easy-smart/stm32f4_uno_ethernet/production/jlcpcb_STM32F4_Uno_Ethernet_1.0.0_2023-10-03_12-42-28/jlcO2U302HH33UXtop-4480x3200.png

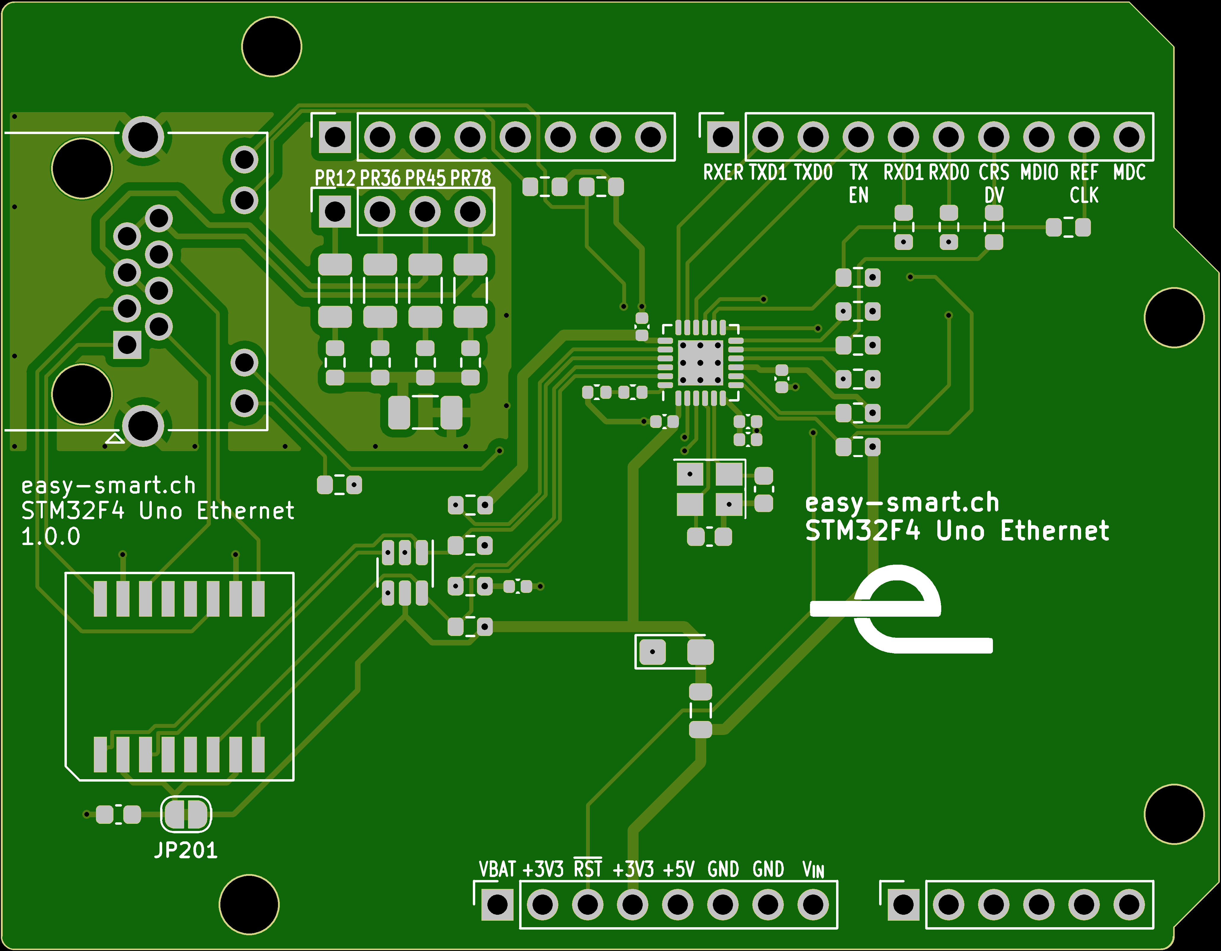
production/jlcpcb_STM32F4_Uno_Ethernet_1.0.0_2023-10-03_12-42-28/jlcO2U302HH33UXtop-4480x3200.png
