easy-smart/stm32f4_uno_ethernet/production/jlcpcb_STM32F4_Uno_Ethernet_1.0.0_2023-10-03_12-42-28/Produce_DanZhi.SMT_Snapshot.Top.4825844A_Y18.SMT02310031417726.png

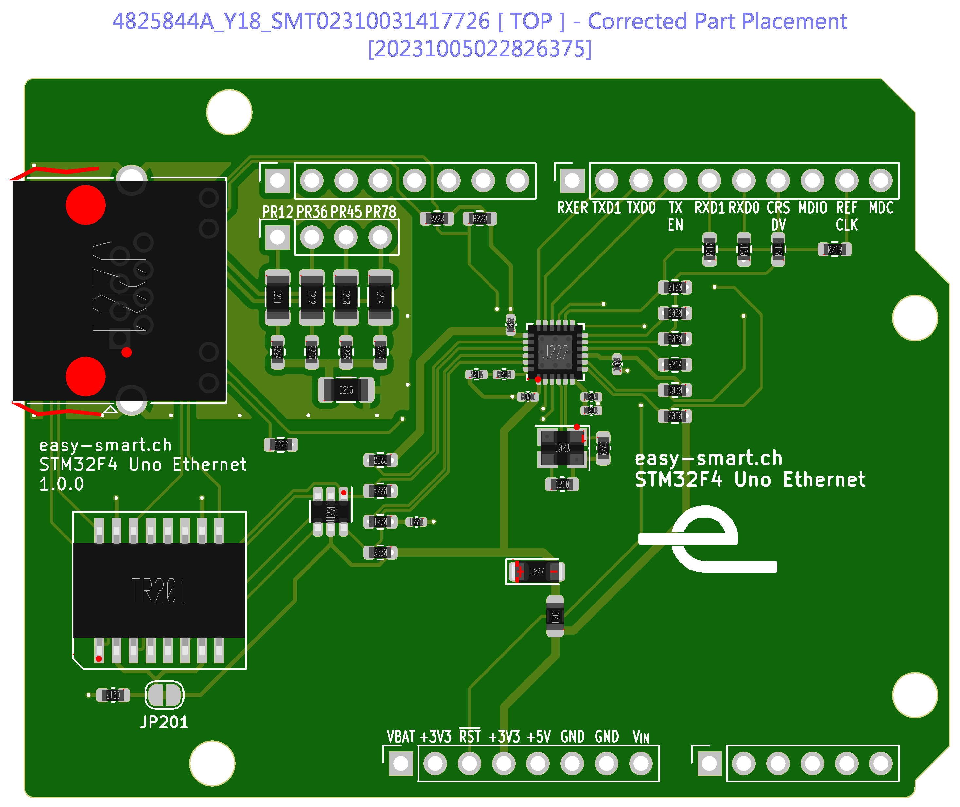
production/jlcpcb_STM32F4_Uno_Ethernet_1.0.0_2023-10-03_12-42-28/Produce_DanZhi.SMT_Snapshot.Top.4825844A_Y18.SMT02310031417726.png
