easy-smart/stm32f4_uno_ethernet/doc/MB1225-F769I-B02_BOM.xlsx

 |  |  | Bill of materials
 |  |  | Board reference: | MB1225
 |  |  | Variant: | None
 |  |  | PCB revision: | B
 |  |  | Assembly revision: | 02
 |  |  | Date: | 30/05/2019
Designator | Description | Value | Footprint | Manuf_1 | Manuf_Part_1 | Fitted | Solder | Quantity
B1 | Non-Open Push-Button 0.1A 24V |  | PB10 | wealthmetal | TD0341X-G01-BLU |  |  | 1
B2 | Non-Open Push-Button 0.1A 24V |  | PB10 | wealthmetal | TD0341X-G01-BLA |  |  | 1
C1, C2, C60 | Capacitor,100nF,16V,X7R,10%,0603,YAGEO | 100nF | 0603C | YAGEO | CC0603KRX7R9BB104 |  |  | 3
C3 | Capacitor,1nF,2KV,X7R,10%,1206,YAGEO | 1nF | 1206C | YAGEO | CC1206KKX7RDBB102 |  |  | 1
C4, C8, C39, C121, C122 | Capacitor,1nF,100V,X7R,10%,0603,YAGEO | 1nF | 0603C | YAGEO | CC0603KRX7R0BB102 |  |  | 5
C5, C10 | Capacitor,10nF,100V,X7R,10%,0603,YAGEO | 10nF | 0603C | YAGEO | CC0603KRX7R0BB103 |  |  | 2
C6, C7, C11, C12 | Capacitor,100nF,50V,X7R,10%,0603,YAGEO | 100nF | 0603C | YAGEO | CC0603KRX7R9BB104 |  |  | 4
C9 | Capacitor,470pF,100V,X7R,10%,0603,AVX | 470pF | 0603C | AVX | 06031C471KAT2A |  |  | 1
C13, C14, C15, C18 | Capacitor,47uF,10V,X5R,20%,0805,MURATA | 47uF | 0805C | MURATA | GRM21BR61A476ME15K |  |  | 4
C16 | Capacitor,100nF,16V,X7R,10%,0603,YAGEO | 100nF | 0603C | YAGEO | CC0603KRX7R9BB104 |  |  | 1
C17 | Capacitor,100pF,50V,X7R,10%,0603,AVX | 100pF | 0603C | AVX | 06035C101JAT4A |  |  | 1
C19 | Capacitor,22nF,50V,X7R,10%,0603,YAGEO | 22nF | 0603C | YAGEO | CC0603KRX7R9BB223 |  |  | 1
C20, C70, C75 | Capacitor,4.7uF,100V, X7S,20%,1206,AVX | 4.7uF | 1206C | AVX | 12061Z475MAT2A |  |  | 3
C21 | Capacitor,560pF,16V,X7R,10%,0603,AVX | 560pF | 0603C | AVX | 0603YC561KAT2A |  |  | 1
C22 | Capacitor,27pF,100V,NPO,5%,0603,YAGEO | 27pF | 0603C | YAGEO | CC0603JRNPO0BN270 | NO |  | 1
C23 | Capacitor,2.2uF,16V, X7R,10%,1206,YAGEO | 2.2uF | 1206C | YAGEO | CC1206KKX7R7BB225 | NO |  | 1
C24, C66 | Capacitor,1uF,25V,X5R,10%,0603,YAGEO | 1uF | 0603C | YAGEO | CC0603KRX5R8BB105 |  |  | 2
C25, C74, C78, C82 | Capacitor,2.2uF,10V, X5R,10%,0603,YAGEO | 2.2uF | 0603C | YAGEO | CC0603KRX5R6BB225 |  |  | 4
C26, C32, C34, C37 | Capacitor,1nF,100V,X7R,10%,0603,YAGEO | 1nF | 0603C | YAGEO | CC0603KRX7R0BB102 |  |  | 4
C27, C30, C33, C35, C42, C44, C45, C46, C49, C50, C53, C54, C55, C56, C57, C59, C64, C65, C71, C76, C80, C83, C86, C87, C88, C91, C97, C98, C99, C102, C103, C104, C105, C106, C107, C108, C109, C110, C111, C112, C113, C114, C115, C117, C118, C132, C140, C143, C144, C145, C146, C149, C150, C151, C152, C153, C154, C156, C157 | Capacitor,100nF,16V,X7R,10%,0402,YAGEO | 100nF | 0402C | YAGEO | CC0402KRX7R7BB104 |  |  | 59
C28, C41, C47, C48, C51, C58, C62, C63, C67, C90, C155 | Capacitor,1uF,16V,X5R,10%,0603,YAGEO | 1uF | 0603C | YAGEO | CC0603KRX5R7BB105 |  |  | 11
C29 | Capacitor,470pF,16V,X7R,10%,0402,YAGEO | 470pF | 0402C | YAGEO | 0402YC471KAT4A |  |  | 1
C31, C72 | Capacitor,2.2uF,16V, X7R,10%,1206,YAGEO | 2.2uF | 1206C | YAGEO | CC1206KKX7R7BB225 |  |  | 2
C36, C38, C61 | Polarized Capacitor,10uF,10V,10%,typeA,VISHAY | 10uF | TAN-A | VISHAY | 293D106X9010A2TE3 |  |  | 3
C40, C81 | Capacitor,100nF,100V,X7R,10%,0805,TDK | 100nF | 0805C | TDK | C2012X7R2A104K125AA |  |  | 2
C43 | Capacitor,10nF,50V,X7R,10%,0603,YAGEO | 10nF | 0603C | YAGEO | CC0603KRX7R9BB103 |  |  | 1
C52 | Capacitor,2.2uF,16V, X7R,10%,0805,YAGEO | 2.2uF | TAN-A | YAGEO | CC0805KKX7R7BB225 |  |  | 1
C68, C69 | Polarized Capacitor,4.7uF,16V,10%,typeA,AVX | 4.7uF | TAN-A | AVX | TAJA475K016R |  |  | 2
C73, C79, C92, C93, C94, C95 | Capacitor,4.7uF,16V, X5R,10%,0603,YAGEO | 4.7uF | 0603C | YAGEO | CC0603KRX5R7BB475 |  |  | 6
C77, C84 | Capacitor, 3pF, 16V, NPO, -+0.25pF, 0402, KEMET | 3pF | 0402C | AVX | C0402C439C4GACTU |  |  | 2
C85 | Capacitor,NA,0402 | [NA] | 0402C |  |  | NO |  | 1
C89 | Capacitor,1nF,2KV,X7R,10%,1206,YAGEO | 1nF | 1206C | YAGEO | CC1206KKX7RDBB102 |  |  | 1
C96, C123, C124, C125, C126, C127, C128, C130, C131, C133, C134, C135, C136, C137, C138, C147 | Capacitor,100nF,16V,X7R,10%,0402,YAGEO | 100nF | 0402C | YAGEO | CC0402KRX7R7BB104 |  |  | 16
C100 | Capacitor,10uF,6.3V,X5R,10%,0603,YAGEO | 10uF | 0603C | YAGEO | CC0603KRX5R5BB106 |  |  | 1
C101, C116 | Polarized Capacitor,1uF,16V,10%,typeA,AVX | 1uF | TAN-A | AVX | TAJA105K016R |  |  | 2
C119, C120 | Capacitor,22nF,16V,X7R,10%,0402,YAGEO | 22nF | 0402C | YAGEO | CC0402KRX7R7BB223 |  |  | 2
C129, C139 | Capacitor,10uF,25V,X5R,10%,0805,YAGEO | 10uF | 0805C | YAGEO | CC0805KRX5R8BB106 |  |  | 2
C141, C142 | Capacitor,10pF,50V,NPO,5%,0402,YAGEO | 10pF | 0402C | YAGEO | CC0402JRNPO9BN100 |  |  | 2
C148 | Capacitor,4.7uF,16V, X5R,10%,0603,YAGEO | 4.7uF | 0603C | YAGEO | CC0603KRX5R7BB475 |  |  | 1
C200 | Capacitor,10nF,50V,X7R,10%,0603,YAGEO | 10nF | 0603C | YAGEO | CC0603KRX7R9BB103 |  |  | 1
CN1 | HIGH SPEED SOCKET STRIP, .5mm PITCH, 60 PINS |  | QSH-030-01-F-D-A | SAMTEC | QSH-030-01-F-D-A-K-TR |  |  | 1
CN2 | Header Female, 4-Pin, Dual row, Straight |  | HDR_2X4_2R54 | Fischer Electronik | BL 2-8G |  |  | 1
CN3 | Header Male, 5-Pin, Dual row, Straight, AMD |  | HDR_2X5_2R54 | AMD | 826632-5 |  |  | 1
CN4 | Header, 4-Pin |  | HDR_1X4_2R54 |  |  | NO |  | 1
CN5 | Memory Card Connectors MicroSD Card Conn Revrs Mnt Push-Push |  | MSD_PJS008_ | YAMAICHI | PJS008-2003-1 |  |  | 1
CN6 | Connector Jack Stereo 3.5mm, female SMT, Blue (Line input) |  | PJ3028B | http://ww.qiaod.com | PJ3028B-3_BE |  |  | 1
CN7 | Connector Jack Stereo 3.5mm, female SMT, Green (Line output) |  | PJ3028B | http://ww.qiaod.com | PJ3028B-3_GR |  |  | 1
CN8 | RCA Phono Jack, Right Angle, SMD, Yellow |  | PHONE_JACK_JBB0819100002 | JIUBABA | JBB0819100002 |  |  | 1
CN9 | Header, 10-Pin, Single row, female, THT, 2.54 |  | HDR_1X10_2R54_W | Fischer Electronik | BL 1-10 G |  |  | 1
CN10 | 100 Base-TX (Fast Ethernet) RJ45 single port (1x1) with LEDS Integrated Connector |  | RJ45_LED_KRJ-CB4R2GYZNL_EM | DGKYD | KRJ-CB4.2GYZNL |  |  | 1
CN11, CN13 | Header, 8-Pins, Single row, female, THT, 2.54 |  | HDR_1X8_2R54_W | Fischer Electronik | BL 1-8 G |  |  | 2
CN12 | RCA Phono Jack, Right Angle, SMD, White |  | PHONE_JACK_JBB0819100002 | JIUBABA | JBB0819100004 |  |  | 1
CN14 | Header, 6-Pins, Single row, female THT, 2.54 |  | HDR_1X6_2R54_W | Fischer Electronik | BL 1-6 G |  |  | 1
CN15 | USB-MICRO-AB, 47590-0001, SMT, MOLEX |  | MOLEX_47590001 | MOLEX | 47590-0001 |  |  | 1
CN16 | USB-MICRO-B, 1050170001, SMT, MOLEX |  | MICRO_USB_B_105017 | MOLEX | 1050170001 |  |  | 1
D1, D3 | Schottky Single diode(150mA, 100V) |  | SOD-323 | STM | BAT46JFILM |  |  | 2
D2 | Low drop power Schottky rectifier(2A, 40V, 0.34V) |  | SMB | STM | STPS2L40UF |  |  | 1
D4, D9 | Surface Mount Bridge Rectifiers |  | DBS101-107G | VISHAY | DF01S |  |  | 2
D5, D6, D7, D8, D11 | BAT60JFILM |  | SOD-323 | STM | BAT60JFILM |  |  | 5
D10 | Transil 400W, VRM=58V |  | SMA | STM | SMAJ58A-TR |  |  | 1
D12 | Quad bidirectional Transil array for ESD protection |  | BGA4_0R4_0R8X0R8 | STM | ESDA14V2-2BF3 |  |  | 1
D13 | 2-line Transil, (TVS), ultralow capacitance protection for high speed USB |  | BGA4_0R4_0R8X0R8 | STM | USBULC6-2F3 |  |  | 1
H1, H2, H6, H7 |  |  | HOLE_C6D3R5 |  |  |  |  | 4
H3, H8 |  |  | HOLE_C9D4R5-1 |  |  |  |  | 2
H4, H5 |  |  | HOLE_C9D4R5 |  |  |  |  | 2
JP1 | Header, 2-Pins, Single row, Right Angle, 2.54 mm pitch, DIP |  | HDR_1X2_2R54_RA_11R35 | ATOM | WF25402-06421 |  |  | 1
JP2, JP3, JP4, JP5 |  |  | SIP2 |  |  | NO |  | 4
L2, L7, L8 | Bead,120R,2A,0603,BLM18PG121SN1D,MURATA | 100uH | 0603L | MURATA | BLM18PG121SN1D |  |  | 3
L3, L4, L6 | Bead,600R,350mA,0603,FCM1608KF-601T03,Tai-tech | 100uH | 0603L | Tai-tech | FCM1608KF-601T03 |  |  | 3
L5 | Power Inductor, 5.6uH, 0.2R, ME3220-562ML, CoilCraft | 5.6uH | LSM2_3R2X2R8_H2 | CoilCraft | ME3220-562ML |  |  | 1
LD1, LD4, LD6, LD7 | LED, red, 0603 |  | 0603D | everlight | 19-213-R6C-AP1Q2B/3T |  |  | 4
LD2, LD3, LD5 | LED, green, 0603 |  | 0603D | everlight | 19-213SYGC/S530-E2/TR8 |  |  | 3
LD8 | Bicolor Led |  | LED2_3528 | Avago Technologies | HSMF-A201-A00J1 |  |  | 1
R1 | Resistor,75K,0603,1%,YAGEO | 75K | 0603R | YAGEO | RC0603FR-0775KL |  |  | 1
R2, R16 | Resistor,0,0603,5%,YAGEO | 0 | 0603R-GS | YAGEO | RC0603JR-070RL |  |  | 2
R3 | Resistor,2K,0805,1%,YAGEO | 2K | 0805R | YAGEO | RC0805FR-072KL |  |  | 1
R4 | Resistor,510,0603,1%,YAGEO | 510 | 0603R | YAGEO | RC0603FR-07510RL |  |  | 1
R5, R62, R85 | Resistor,1K,0603,1%,YAGEO | 1K | 0603R | YAGEO | RC0603FR-071KL |  |  | 3
R6 | Resistor,124K,0603,1%,YAGEO | 124K | 0603R | YAGEO | RC0603FR-07124KL |  |  | 1
R7, R88, R93, R95, R97, R98, R99, R100, R129 | Resistor,0,0402,5%,YAGEO | 0 | 0402R | YAGEO | RC0402JR-070RL |  |  | 9
R8, R28, R29, R30, R34, R40, R43, R45, R51, R52, R54, R56, R68, R70, R71, R87, R108, R122, R144, R147, R200 | Resistor,10K,0402,1%,YAGEO | 10K | 0402R | YAGEO | RC0402FR-0710KL |  |  | 21
R9 | Resistor,0.47,1206,1%,YAGEO | 0.47 | 1206R | YAGEO | RL1206FR-070R47L |  |  | 1
R10 | Resistor,56,0805,1%,YAGEO | 56 | 0805R | YAGEO | RC0805FR-0756RL |  |  | 1
R11 | Resistor,20K,0603,1%,YAGEO | 20K | 0603R | YAGEO | RC0603FR-0720KL |  |  | 1
R12, R13, R25 | Resistor,10K,0603,1%,YAGEO | 10K | 0603R | YAGEO | RC0603FR-0710KL |  |  | 3
R14, R15 | Resistor,13K,0603,1%,YAGEO | 13K | 0603R | YAGEO | RC0603FR-0713KL |  |  | 2
R17, R89, R90, R91 | Resistor,2K7,0402,1%,YAGEO | 2K7 | 0402R | YAGEO | RC0402FR-072K7L |  |  | 4
R18, R20, R86, R106, R107, R134 | Resistor,10K,0402,1%,YAGEO | 10K | 0402R | YAGEO | RC0402FR-0710KL |  |  | 6
R19, R21, R76, R92, R94, R114, R121, R124, R128, R133 | Resistor,[NA],0402 | [NA] | 0402R |  |  | NO |  | 10
R22 | Resistor,15,0805,1%,YAGEO | 15 | 0805R | YAGEO | RC0805FR-0715RL |  |  | 1
R23 | Resistor,200,1206,1%,Rohm | 200 | 1206R | Rohm Semiconductor | LTR18EZPF2000 | NO |  | 1
R24 | Resistor,68,0805,1%,YAGEO | 68 | 0805R | YAGEO | RC0805FR-0768RL |  |  | 1
R26, R33, R42, R46 | Resistor,75,0805,1%,YAGEO | 75 | 0805R | YAGEO | RC0805FR-0775RL |  |  | 4
R27, R116, R117, R143, R145 | Resistor,100,0402,1%,YAGEO | 100 | 0402R | YAGEO | RC0402FR-07100RL |  |  | 5
R31 | Resistor,12K1,0603,1%,VISHAY | 12K1 | 0603R | VISHAY | MCT 0603-50 1% P5 12K1 |  |  | 1
R32, R36, R44 | Resistor,33,0402,1%,YAGEO | 33 | 0402R | YAGEO | RC0402FR-0733RL |  |  | 3
R35, R37, R39, R41 | Resistor,50,0402,1%,YAGEO | 50 | 0402R | YAGEO | RC0402FR-0750RL |  |  | 4
R38 | Resistor,0,0805,5%,YAGEO | 0 | 0805R | YAGEO | RC0805JR-070RL | NO |  | 1
R47, R148 | Resistor,1K5,0402,1%,YAGEO | 1K5 | 0402R | YAGEO | RC0402FR-071K5L |  |  | 2
R48, R49 | Resistor,0,0805,5%,YAGEO | 0 | 0805R | YAGEO | RC0805JR-070RL |  |  | 2
R50, R57, R58, R59, R103 | Resistor,1K,0402,1%,YAGEO | 1K | 0402R | YAGEO | RC0402FR-071KL |  |  | 5
R60, R61, R105, R113 | Resistor,330,0402,1%,YAGEO | 330 | 0402R | YAGEO | RC0402FR-07330RL |  |  | 4
R63 | Resistor,330,0603,1%,YAGEO | 330 | 0603R | YAGEO | RC0603FR-07330RL |  |  | 1
R64 | Resistor,510,0402,1%,YAGEO | 510 | 0402R | YAGEO | RC0402FR-07510L |  |  | 1
R65 | Resistor,620,0603,1%,VISHAY | 620 | 0603R | VISHAY DRALORIC | CRCW0603620RFKEA |  |  | 1
R66 | Resistor,330,0402,1%,YAGEO | 330 | 0402R | YAGEO | RC0402FR-07330RL |  |  | 1
R67 | Resistor,10K,0402,1%,YAGEO | 10K | 0402R | YAGEO | RC0402FR-0710KL | NO |  | 1
R73, R123, R125, R126, R137 | Resistor,0,0402,5%,YAGEO | 0 | 0402R | YAGEO | RC0402JR-070RL |  |  | 5
R74, R109, R110 | Resistor,0,0603,5%,YAGEO | 0 | 0603R-GS | YAGEO | RC0603JR-070RL |  |  | 3
R75 | Resistor,10,0805,1%,Stackpole,1/4W | 10 | 0805R | Stackpole Electronics Inc | RNCP0805FTD10R0 |  |  | 1
R77, R78 | Resistor,20,0402,1%,YAGEO | 20 | 0402R | YAGEO | RC0402FR-0720RL |  |  | 2
R79, R80, R81, R82, R83, R132 | Resistor,47K,0402,1%,YAGEO | 47K | 0402R | YAGEO | RC0402FR-0747KL |  |  | 6
R84, R96 | Resistor,0,0805,5%,YAGEO | 0 | 0805R | YAGEO | RC0805JR-070RL |  |  | 2
R101 | Resistor,210,0402,1%,YAGEO | 210 | 0402R | YAGEO | RC0402FR-07210RL |  |  | 1
R102 | Resistor,110,0402,1%,YAGEO | 110 | 0402R | YAGEO | RC0402FR-07110RL |  |  | 1
R104, R136 | Resistor,100,0402,1%,YAGEO | 100 | 0402R | YAGEO | RC0402FR-07100RL |  |  | 2
R111 | Resistor,75,0402,1%,YAGEO | 75 | 0402R | YAGEO | RC0402FR-0775RL |  |  | 1
R112, R115 | Resistor,1M,0402,1%,YAGEO | 1M | 0402R | YAGEO | RC0402FR-071ML |  |  | 2
R118, R127, R131 | Resistor,100K,0402,1%,YAGEO | 100K | 0402R | YAGEO | RC0402FR-07100KL |  |  | 3
R119, R120 | Resistor,4K7,0402,1%,YAGEO | 4K7 | 0402R | YAGEO | RC0402FR-074K7L |  |  | 2
R130 | Resistor,3K3,0402,1%,YAGEO | 3K3 | 0402R | YAGEO | RC0402FR-073K3L |  |  | 1
R135 | Resistor,4K7,0402,1%,YAGEO | 4K7 | 0402R | YAGEO | RC0402FR-074K7L |  |  | 1
R138 | Resistor,0,0402,5%,YAGEO | 0 | 0402R | YAGEO | RC0402JR-070RL | NO |  | 1
R139 | Resistor,8K06,0402,1%,YAGEO | 8K06 | 0402R | YAGEO | RC0402FR-078K06L |  |  | 1
R140 | Resistor,2K2,0402,1%,YAGEO | 2K2 | 0402R | YAGEO | RC0402FR-072K2L |  |  | 1
R141 | Resistor,2K7,0402,1%,YAGEO | 2K7 | 0402R | YAGEO | RC0402FR-072K7L |  |  | 1
R142 | Resistor,820,0805,1%,YAGEO | 820 | 0805R | YAGEO | RC0805FR-07820RL |  |  | 1
R146 | Resistor,36K,0402,1%,YAGEO | 36K | 0402R | YAGEO | RC0402FR-0736KL |  |  | 1
R149, R150 | Resistor,100K,0402,1%,YAGEO | 100K | 0402R | YAGEO | RC0402FR-07100KL |  |  | 2
SB1, SB2, SB3, SB4, SB7, SB8, SB9, SB10, SB12, SB14, SB15, SB17, SB18, SB19, SB20, SB21, SB22 | Solder Bridge ON |  | JP2_SMD |  |  |  | YES | 17
SB5, SB6, SB11, SB13, SB16, SB23 | Solder Bridge OFF |  | JP2_SMD |  |  |  | NO | 6
T1 | N-channel 200 V, 1.1ohm, 1 A, low gate charge STripFET II, Power MOSFET |  | SOT-223 | ST | STN4NF20L |  |  | 1
T2 | Flyback Transformers for 3 Watt, PoE applications, CoilCraft Cyntec |  | TF_10R9X13R2-12R2X14R4_CPT | CoilCraft | POEP30P50L |  |  | 1
T3, T5 | NPN Bipolar Transistor |  | SOT-23 | NXP | BSR14 |  |  | 2
T4 | 10/100BASE-TX VoIP Magnetics Modules, Data Transformer |  | TF_16SM_12R7X9R65 | PULSE | H2019NL |  |  | 1
T100 | Flyback Transformers for 3 Watt, PoE applications, Wurth |  | TF_8SM_12R04X12R85 | Wurth | 750315923 | NO |  | 1
TP1, TP2, TP3, TP5, TP6, TP7, TP8, TP9, TP11, TP12, TP13, TP14, TP15, TP16, TP17, TP18, TP21, TP22, TP26, TP27, TP28, TP100, TP101, TP102, TP103, TP104, TP105, TP106, TP107, TP108, TP109 | Test Point |  | TP_C40 |  |  |  |  | 31
TP20 | Test Point |  | TP |  |  | NO |  | 1
U1 | Integrated IEEE 802.3af compliant PoE-PD interface, and PWM controller with support of external source |  | TSSOP16_0R65_5x6R4_TP | ST | PM8800ATR |  |  | 1
U2 | Low voltage adjustable shunt reference |  | SOT23-5 | ST | TS431AILT |  |  | 1
U3 | LAN8742A-CZ-TR - Small Footprint RMII 10/100 Ethernet, Transceiver with HP Auto-MDIX and flexPWR Technology SQFN-24 |  | QFN24_0R5_4X4 | MICROCHIP | LAN8742A-CZ-TR |  |  | 1
U4 | Ultra low drop-low noise BiCMOS voltage, regulators low ESR capacitors compatible |  | SOT-23-5L | STM | LD3985M33R |  |  | 1
U5, U6, U8, U9 | MEMS audio sensor, omnidirectional digital microphone |  | MP34DT01TR | STM | MP34DT01TR-M |  |  | 4
U7 | Ultra low drop-low , 500 mA low quiescent current |  | DFN6_0R95_3X3 | STM | LD39050PU33R |  |  | 1
U10 | OPTOISOLATOR 3.7KV TRANSISTOR 4SMD |  | PC_4SM_1R27_2R5X6R8 | FAIRCHILD | HMHA2801A |  |  | 1
U11 | Multi-Channel Audio Hub CODEC for Smartphones |  | BGA72_0R5_4R5X4 | Cirrus Logic | WM8994ECS/R |  |  | 1
U12 | 512Mb, 3V, Multiple I/O Serial Flash Memory, Quad/Dual |  | DFN8_1R27_6X8_TP4R8X5R16 | MICRON | MT25QL512ABB1EW9-0SIT | NO |  | 1
U13 | STM32F769NIH6 (STM32F7 Big Birdie) TBGA216 |  | BGA216_0R8_13X13 | STM | STM32F769NIH6U |  |  | 1
U14 | LOW DROP FIXED AND ADJUSTABLE POSITIVE VOLTAGE REGULATORS (1.8 Volts) |  | SOT-223 | STM | LD1117S18TR |  |  | 1
U15, U16 | Single inverter gate with a standard push-pull output. (1.65V to 5.5V) |  | SOT-353 | DIODES | 74LVC1G04SE-7 |  |  | 2
U17 | SDRAM 128MBIT (4M x 32) 166MHZ 90-VFBGA (8x13) |  | FBGA90_0R8_8X13 | MICRON | MT48LC4M32B2B5-6A IT:L TR |  |  | 1
U18 | IC REG LDO 5V 0.8A SOT223 |  | SOT-223 | STM | LD1117S50TR |  |  | 1
U19 | Medium-density performance line ARM-based 32-bit MCU with 128KB Flash |  | LQFP48_0R5_9X9 | STM | STM32F103CBT6 |  |  | 1
U20 | USB3320C, Hi-Speed USB Host, Device or OTG PHY with ULPI Low Pin Interface |  | QFN32_0R5_5X5 | MICROCHIP | USB3320C-EZK-TR |  |  | 1
U21 | Enhanced single channel power switches |  | SOT23-5 | STM | STMPS2151STR |  |  | 1
U22 | 1.2 A current limited high-side power switch with thermal shutdown |  | SOIC8_1R27_4R9X6 | STM | ST890CDR |  |  | 1
U250 | 512Mb, 3V, Multiple I/O Serial Flash Memory, Quad/Dual |  | SON8_1R27_6X8 | MACRONIX | MX25L51245GZ2I-08G |  |  | 1
X1 | Crystal 32.768kHz, 6pF, -+20PPM, R=50K, SMD |  | XTAL_2SM_3R2X1R5 | NDK | NX3215SA 32.768KHz EXS00A-MU00525 |  |  | 1
X2 | Oscillator 25.00Mhz, -+50PPM, 3.3V, Temp -55 to +125°C |  | OSC_4SM_2R5X2 | NDK | NZ2520SB 25MHz END4869B |  |  | 1
X3 | Crystal 8Mhz, 8pF, -+50PPM, SMD |  | XTAL_2SM_3R2X2R5_H1 | NDK | NX3225GD 8MHz EXS00A-CG04874 |  |  | 1
X4 | Oscillator 24.00Mhz, -+50PPM, 3.3V, Temp -55 to +125°C |  | OSC_4SM_2R5X2 | NDK | NZ2520SB 24MHz END4869A |  |  | 1
