easy-smart/stm32f4_uno_ethernet/(threads)

Thread 8 (2024-11-28):

Add all pin sockets on ethernet

rrusch, 2024-11-28:

rrusch, 2024-11-28:
Does not work for J101 and J103 because of the ethernet connector

Closed 2024-11-28.
