easy-smart/stm32f4_uno_ethernet/stm32f4_uno_ethernet.kicad_pcb

## KiCad design stm32f4_uno_ethernet.kicad_pcb (2024-11-28)

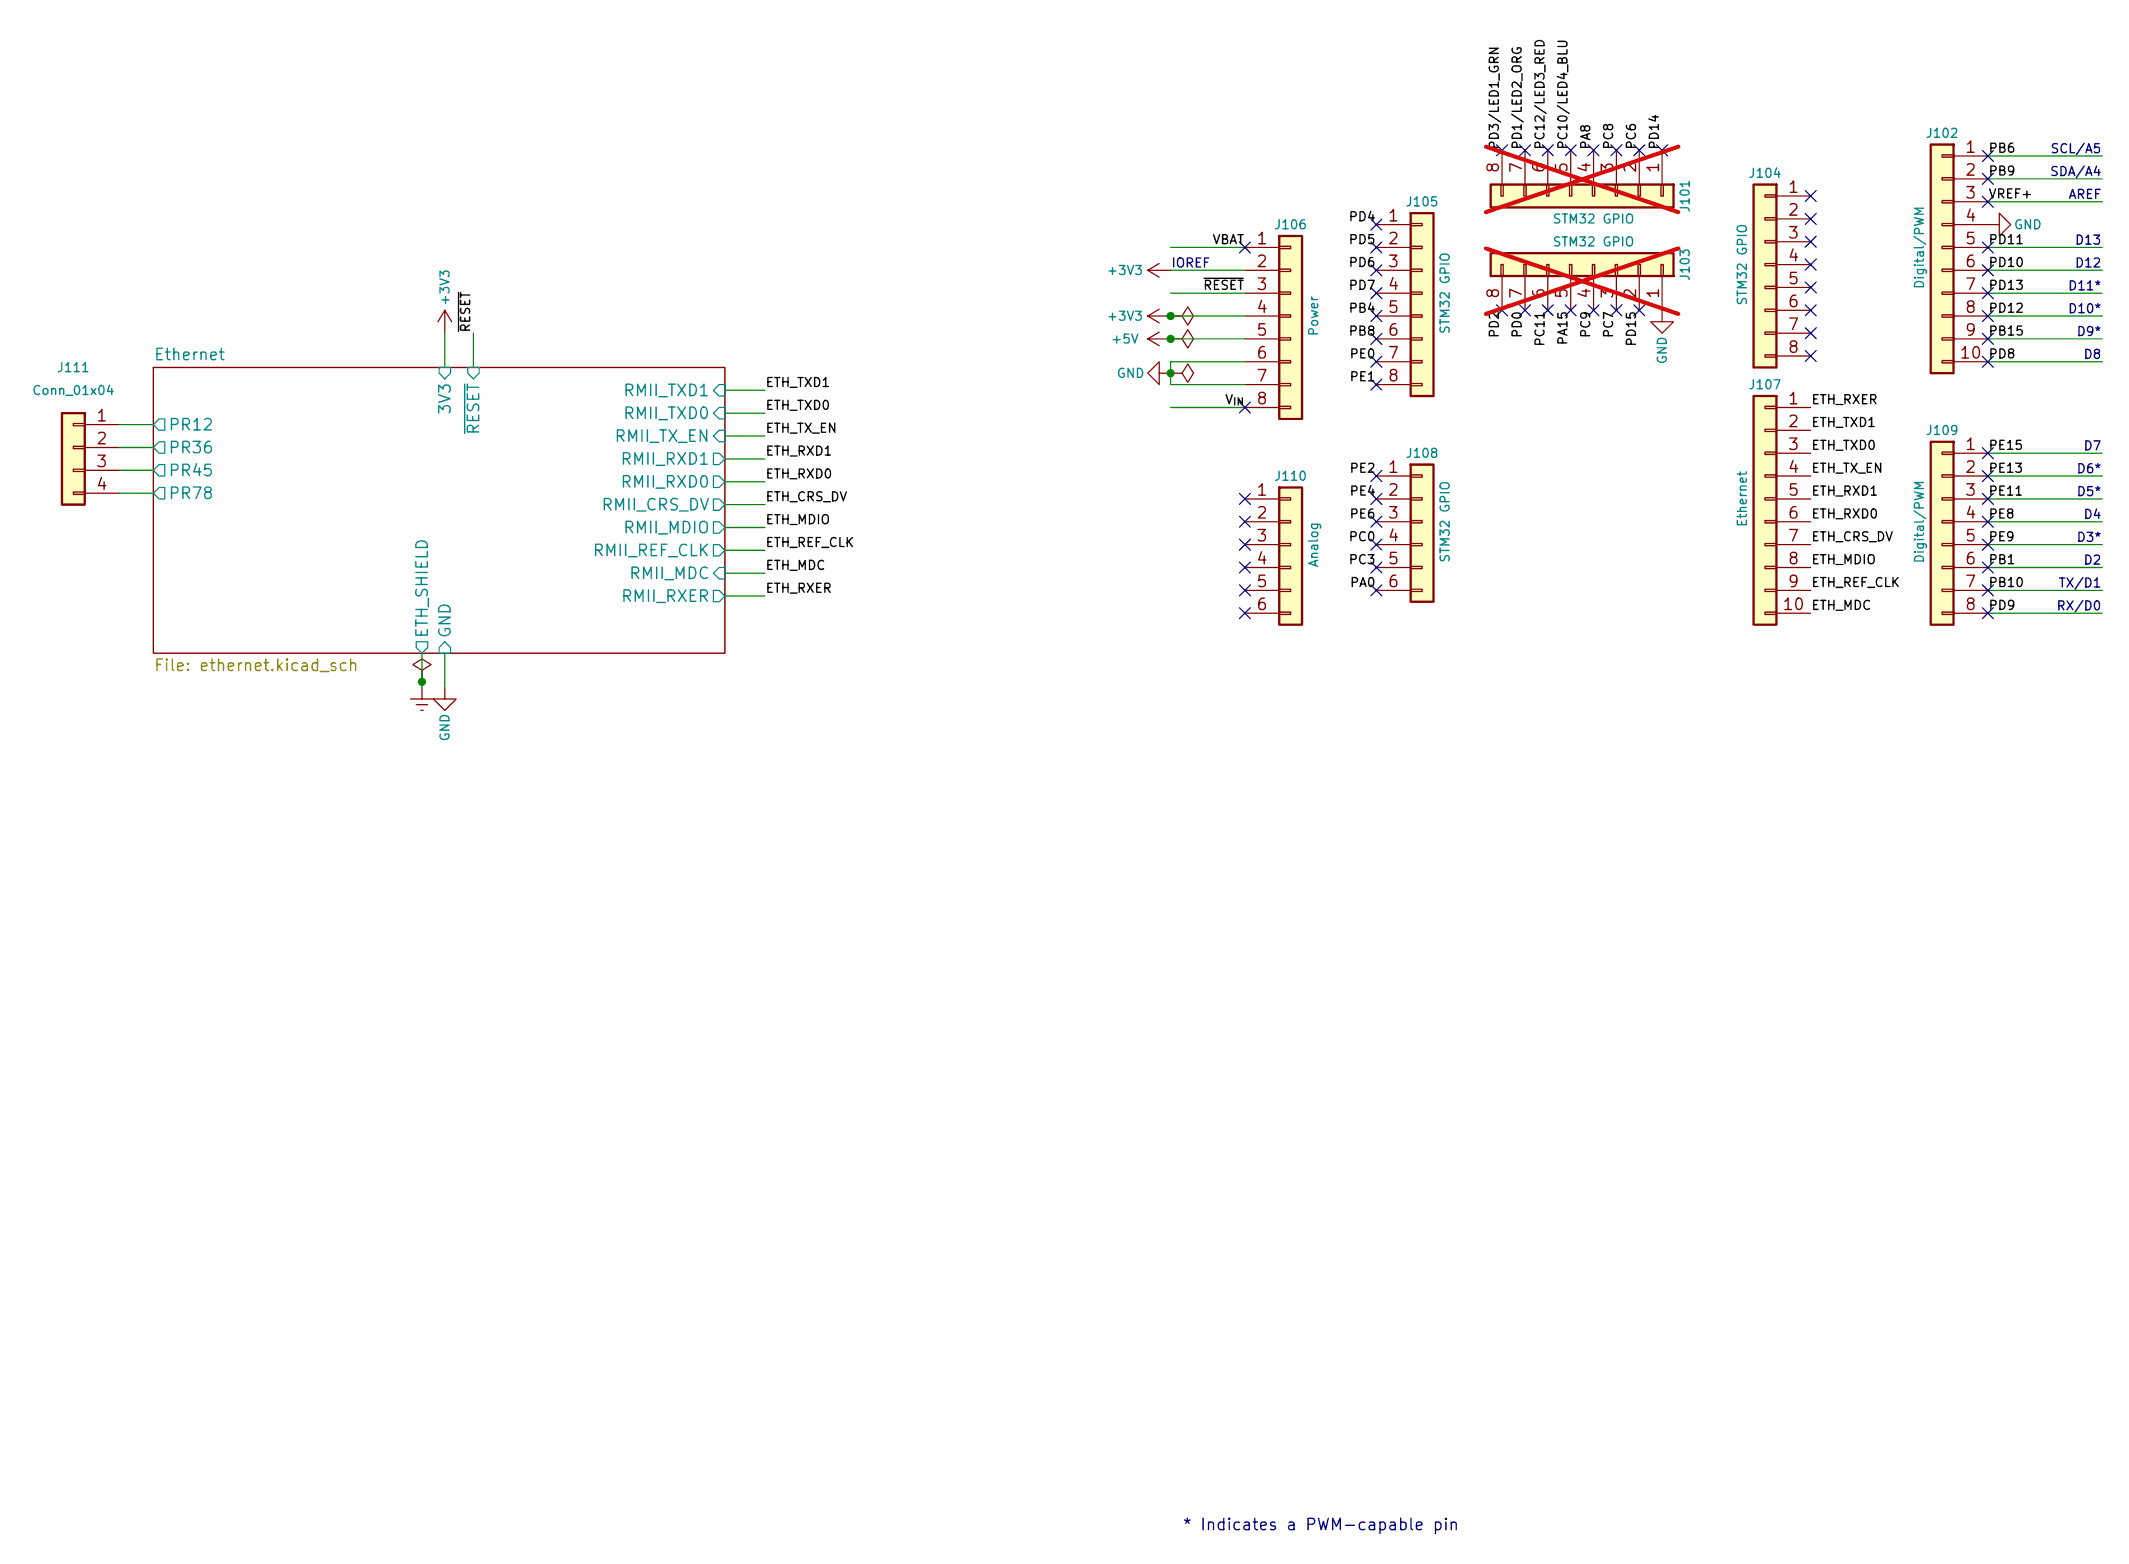
[picture p9: schematic stm32f4_uno_ethernet.kicad_sch, STM32F4 Uno Ethernet]

Parts:
J101, J103: STM32 GPIO; PinSocket_1x08_P2.54mm_Vertical; not fitted
J102: Digital/PWM; PinSocket_1x10_P2.54mm_Vertical
J104, J105: STM32 GPIO; PinSocket_1x08_P2.54mm_Vertical
J106: Power; PinSocket_1x08_P2.54mm_Vertical
J107: Ethernet; PinSocket_1x10_P2.54mm_Vertical
J108: STM32 GPIO; PinSocket_1x06_P2.54mm_Vertical
J109: Digital/PWM; PinSocket_1x08_P2.54mm_Vertical
J110: Analog; PinSocket_1x06_P2.54mm_Vertical
J111: Conn_01x04; PinSocket_1x04_P2.54mm_Vertical

Connections:
+3V3: J106.2, J106.4; also elsewhere on the board
+5V: J106.5
/ETH_CRS_DV: J107.7; also elsewhere on the board
/ETH_MDC: J107.10; also elsewhere on the board
/ETH_MDIO: J107.8; also elsewhere on the board
/ETH_REF_CLK: J107.9; also elsewhere on the board
/ETH_RXD0: J107.6; also elsewhere on the board
/ETH_RXD1: J107.5; also elsewhere on the board
/ETH_RXER: J107.1; also elsewhere on the board
/ETH_TXD0: J107.3; also elsewhere on the board
/ETH_TXD1: J107.2; also elsewhere on the board
/ETH_TX_EN: J107.4; also elsewhere on the board
/Ethernet/PR12: J111.1; also elsewhere on the board
/Ethernet/PR36: J111.2; also elsewhere on the board
/Ethernet/PR45: J111.3; also elsewhere on the board
/Ethernet/PR78: J111.4; also elsewhere on the board
/PA0: J108.6
/PB1: J109.6
/PB4: J105.5
/PB6: J102.1
/PB8: J105.6
/PB9: J102.2
/PB10: J109.7
/PB15: J102.9
/PC0: J108.4
/PC3: J108.5
/PD4: J105.1
/PD5: J105.2
/PD6: J105.3
/PD7: J105.4
/PD8: J102.10
/PD9: J109.8
/PD10: J102.6
/PD11: J102.5
/PD12: J102.8
/PD13: J102.7
/PE0: J105.7
/PE1: J105.8
/PE2: J108.1
/PE4: J108.2
/PE6: J108.3
/PE8: J109.4
/PE9: J109.5
/PE11: J109.3
/PE13: J109.2
/PE15: J109.1
/VBAT: J106.1
/VREF+: J102.3
/V_{IN}: J106.8
/~RESET: J106.3; also elsewhere on the board
GND: J102.4, J103.1, J106.6, J106.7; also elsewhere on the board

Notes on the sheet:
AREF
D13
D10*
SCL/A5
SDA/A4
D9*
* Indicates a PWM-capable pin
TX/D1
D3*
D6*
RX/D0
D11*
IOREF
D5*
D12

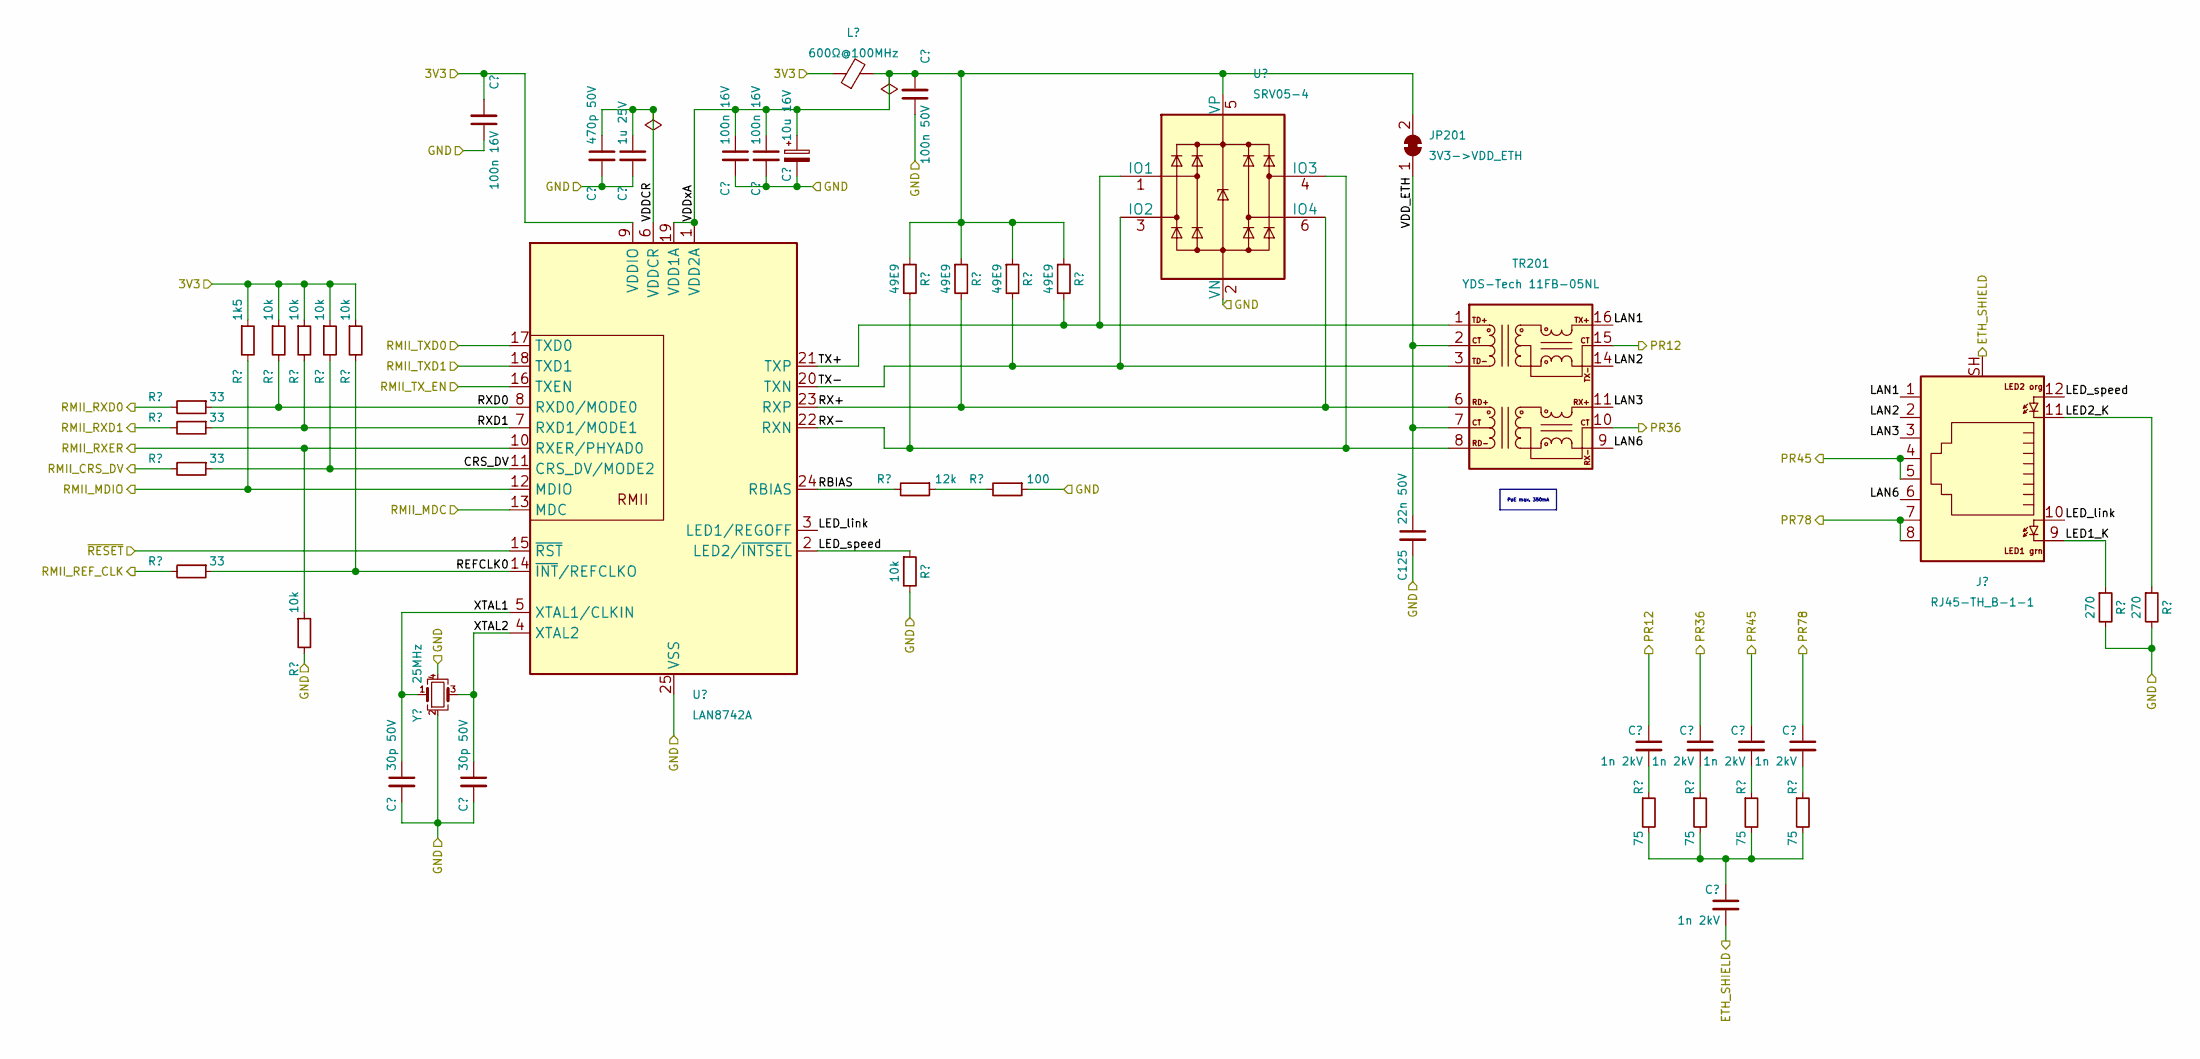
[picture p10: schematic ethernet.kicad_sch, STM32F4 Uno Ethernet]

Parts:
C125: 22n 50V; C_0603_1608Metric; Partnumber CL10B223KB8NNNC; JLCPCB Part # C21122
C201: 100n 50V; C_0402_1005Metric; Partnumber CL05B104KB54PNC; JLCPCB Part # C307331
C202, C205, C206: 100n 16V; C_0402_1005Metric; Manufacturer_Part_Number CL05B104KO5NNNC; JLCPCB Part # C1525
C203: 470p 50V; C_0402_1005Metric; Partnumber 0402B471K500NT; JLCPCB Part # C1537
C204: 1u 25V; C_0402_1005Metric; Partnumber CL05A105KA5NQNC; JLCPCB Part # C52923
C207: 10u 16V; CP_EIA-3216-18_Kemet-A; Partnumber TAJA106K016RNJ; JLCPCB Part # C7171
C209, C210: 30p 50V; C_0603_1608Metric; Partnumber 0603CG300J500NT; JLCPCB Part # C1658
C211, C212, C213, C214, C215: 1n 2kV; C_1206_3216Metric; Partnumber 1206B102K202NT; JLCPCB Part # C9196
J201: RJ45-TH_B-1-1; Boomele RJ45-TH_B-1-1; Partnumber RJ45-B-1*1; JLCPCB Part # C138392
JP201: 3V3->VDD_ETH; SolderJumper-2_P1.3mm_Bridged_RoundedPad1.0x1.5mm
L201: 600Ω@100MHz; L_0805_2012Metric; Manufacturer_Part_Number GZ2012D601TF; JLCPCB Part # C1017
R201, R202, R203, R204: 49E9; R_0603_1608Metric; Partnumber 0603WAF499JT5E; JLCPCB Part # C23185
R206, R207, R208, R210, R214, R220: 10k; R_0603_1608Metric; Partnumber 0603WAF1002T5E; JLCPCB Part # C25804
R209: 1k5; R_0603_1608Metric; Partnumber 0603WAF1501T5E; JLCPCB Part # C22843
R211, R212, R215, R219: 33; R_0603_1608Metric; Partnumber 0603WAF330JT5E; JLCPCB Part # C23140
R216: 12k; R_0402_1005Metric; Partnumber 0402WGF1202TCE; JLCPCB Part # C25752
R217: 100; R_0402_1005Metric; Partnumber 0402WGF1000TCE; JLCPCB Part # C25076
R222, R223: 270; R_0603_1608Metric; Partnumber 0603WAF2700T5E; JLCPCB Part # C22966
R224, R225, R226, R227: 75; R_0603_1608Metric; Partnumber 0603WAF750JT5E; JLCPCB Part # C4275
TR201: YDS-Tech 11FB-05NL; Partnumber VP6019 HF; JLCPCB Part # C4154986
U201: SRV05-4; SOT-23-6; Partnumber SRV05-4-P-T7; JLCPCB Part # C85364
U202: LAN8742A; LAN8742AI-CZ-TR; Partnumber LAN8742AI-CZ-TR; JLCPCB Part # C621425
Y201: 25MHz; Crystal_SMD_3225-4Pin_3.2x2.5mm; Partnumber X322525MOB4SI; JLCPCB Part # C9006

Connections:
+3V3: C202.2, L201.1, R206.1, R207.1, R208.1, R209.1, R210.1, U202.9 (VDDIO); also elsewhere on the board
/ETH_CRS_DV: R215.2; also elsewhere on the board
/ETH_MDC: U202.13 (MDC); also elsewhere on the board
/ETH_MDIO: R209.2, U202.12 (MDIO); also elsewhere on the board
/ETH_REF_CLK: R219.2; also elsewhere on the board
/ETH_RXD0: R211.2; also elsewhere on the board
/ETH_RXD1: R212.2; also elsewhere on the board
/ETH_RXER: R214.1, U202.10 (RXER/PHYAD0); also elsewhere on the board
/ETH_TXD0: U202.17 (TXD0); also elsewhere on the board
/ETH_TXD1: U202.18 (TXD1); also elsewhere on the board
/ETH_TX_EN: U202.16 (TXEN); also elsewhere on the board
/Ethernet/CRS_DV: R208.2, R215.1, U202.11 (CRS_DV/MODE2)
/Ethernet/LAN1: J201.1, TR201.16 (TD-)
/Ethernet/LAN2: J201.2, TR201.14 (TD+)
/Ethernet/LAN3: J201.3, TR201.11 (RD-)
/Ethernet/LAN6: J201.6, TR201.9 (RD+)
/Ethernet/LED1_K: J201.9, R222.1
/Ethernet/LED2_K: J201.11, R223.1
/Ethernet/LED_link: J201.10, U202.3 (LED1/REGOFF)
/Ethernet/LED_speed: J201.12, R220.1, U202.2 (LED2/~INTSEL)
/Ethernet/PR12: C211.1, TR201.15 (C_TD); also elsewhere on the board
/Ethernet/PR36: C212.1, TR201.10 (C_RD); also elsewhere on the board
/Ethernet/PR45: C213.1, J201.4, J201.5; also elsewhere on the board
/Ethernet/PR78: C214.1, J201.7, J201.8; also elsewhere on the board
/Ethernet/RBIAS: R216.2, U202.24 (RBIAS)
/Ethernet/REFCLK0: R210.2, R219.1, U202.14 (~INT/REFCLKO)
/Ethernet/RX+: R202.2, TR201.6 (RX-), U201.6 (IO4), U202.23 (RXP)
/Ethernet/RX-: R201.2, TR201.8 (RX+), U201.4 (IO3), U202.22 (RXN)
/Ethernet/RXD0: R206.2, R211.1, U202.8 (RXD0/MODE0)
/Ethernet/RXD1: R207.2, R212.1, U202.7 (RXD1/MODE1)
/Ethernet/TX+: R204.2, TR201.1 (TX-), U201.1 (IO1), U202.21 (TXP)
/Ethernet/TX-: R203.2, TR201.3 (TX+), U201.3 (IO2), U202.20 (TXN)
/Ethernet/VDDCR: C203.1, C204.1, U202.6 (VDDCR)
/Ethernet/VDD_ETH: JP201.1 (A), TR201.2 (C_TX), TR201.7 (C_RX); also elsewhere on the board
/Ethernet/VDDxA: C201.2, C205.1, C206.1, C207.1, JP201.2 (B), L201.2, R201.1, R202.1, R203.1, R204.1, U201.5 (VP), U202.1 (VDD2A), U202.19 (VDD1A)
/Ethernet/XTAL1: C209.1, U202.5 (XTAL1/CLKIN), Y201.1
/Ethernet/XTAL2: C210.1, U202.4 (XTAL2), Y201.3
/~RESET: U202.15 (~RST); also elsewhere on the board
Earth: C215.2, J201.SH
GND: C201.1, C202.1, C203.2, C204.2, C205.2, C206.2, C207.2, C209.2, C210.2, R214.2, R217.1, R220.2, R222.2, R223.2, U201.2 (VN), U202.25 (VSS), Y201.2, Y201.4; also elsewhere on the board
unnamed: C211.2, R224.1
unnamed: C212.2, R225.1
unnamed: C213.2, R226.1
unnamed: C214.2, R227.1
unnamed: C215.1, R224.2, R225.2, R226.2, R227.2
unnamed: R216.1, R217.2

Notes on the sheet:
PoE max. 350mA

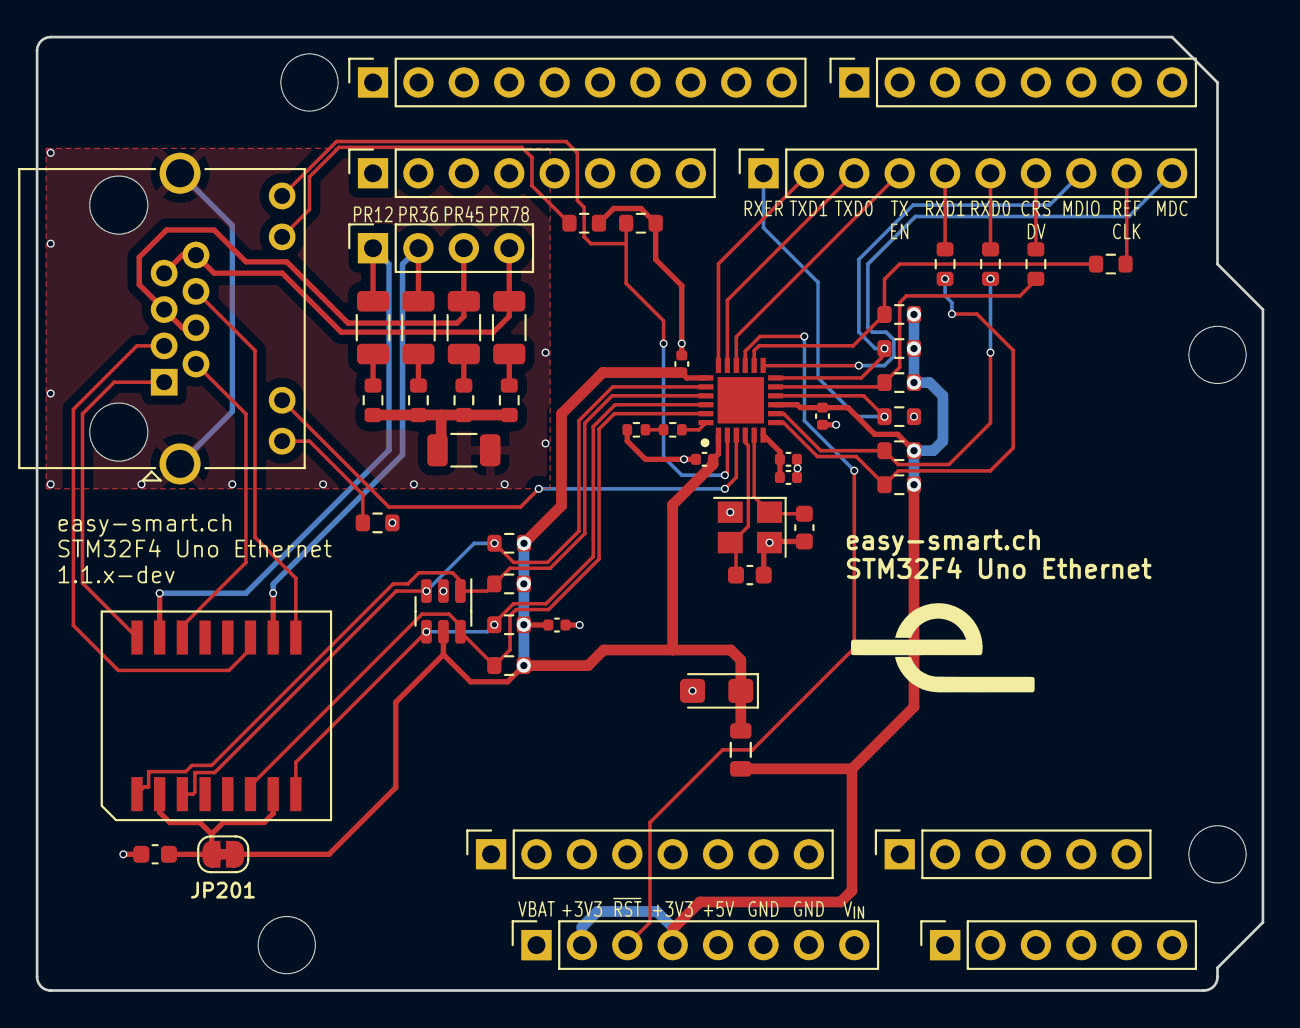
[picture p11: board stm32f4_uno_ethernet.kicad_pcb from above]

Board: 2 copper layers, 68.6 x 53.3 mm, 58 parts (0 on the bottom side), 46 nets.

Other parts of the board:
C217: 22n 50V; C_0603_1608Metric
MH1, MH2, MH3, MH4: MountingHole_3.2mm

Their connections:
/Ethernet/VDD_ETH: C217.1; also elsewhere on the board
GND: C217.2; also elsewhere on the board
