easy-smart/stm32f4_uno_ethernet/(commit log)

2023-09-11 PCB finished
    [ethernet.kicad_sch, stm32f4_uno_ethernet.kicad_pcb, stm32f4_uno_ethernet.kicad_sch]
2023-09-12 Replace transformer, replace RJ45 3D model
    [ethernet.kicad_sch, stm32f4_uno_ethernet.kicad_pcb]
2023-09-12 Change LAN footprint
    [ethernet.kicad_sch, stm32f4_uno_ethernet.kicad_pcb]
2023-09-14 Add ETH_RXER
    [ethernet.kicad_sch, stm32f4_uno_ethernet.kicad_pcb, stm32f4_uno_ethernet.kicad_sch]
2023-09-14 Set DNP
    [MB1225-F769I-B02_BOM.xlsx, ethernet.kicad_sch, stm32f4_uno_ethernet.kicad_pcb, stm32f4_uno_ethernet.kicad_sch]
2023-09-20 #1 Use new central library KiCad-Lib
    [ethernet.kicad_sch, stm32f4_uno_ethernet.kicad_pcb, stm32f4_uno_ethernet.kicad_sch]
2023-09-24 Move PoE pin socket and add earth zone
    [ethernet.kicad_sch, stm32f4_uno_ethernet.kicad_pcb]
2023-10-02 #2 Add silkscreen texts
    [ethernet.kicad_sch, stm32f4_uno_ethernet.kicad_pcb, stm32f4_uno_ethernet.kicad_sch]
2023-10-02 #3 Match pcb to poe and base
2023-10-03 Release 1.0.0 sent to JLCPCB
    [bom.csv, designators.csv, ethernet.kicad_sch, positions.csv, stm32f4_uno_ethernet.kicad_pcb, stm32f4_uno_ethernet.kicad_sch]
2023-10-03 PCB production confirmed
2023-10-14 #4 Wrong polarity on C207
    [ethernet.kicad_sch, stm32f4_uno_ethernet.kicad_pcb, stm32f4_uno_ethernet.kicad_sch]
2023-10-17 Add workflow
    [ethernet.kicad_sch, stm32f4_uno_ethernet.kicad_pcb, stm32f4_uno_ethernet.kicad_sch]
2024-11-28 #8 Add all pin sockets on ethernet
    [ethernet.kicad_sch, stm32f4_uno_ethernet.kicad_pcb, stm32f4_uno_ethernet.kicad_sch]
2024-11-28 #7 Change ethernet signal transformer
    [ethernet.kicad_sch, stm32f4_uno_ethernet.kicad_pcb]
