easy-smart/stm32f4_uno_ethernet/production/jlcpcb_STM32F4_Uno_Ethernet_1.0.0_2023-10-03_12-42-28/Photo Back PCB.jpg

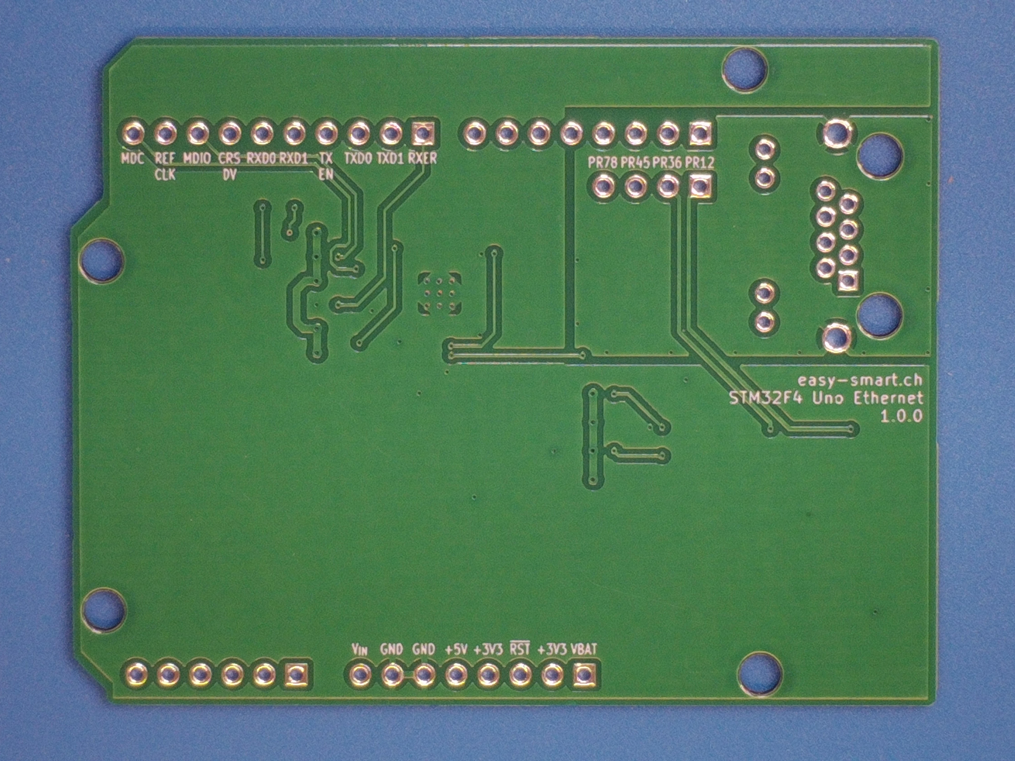
production/jlcpcb_STM32F4_Uno_Ethernet_1.0.0_2023-10-03_12-42-28/Photo Back PCB.jpg
